GabrielHCaribe/drone/CAD/Propeller 10x45.STEP

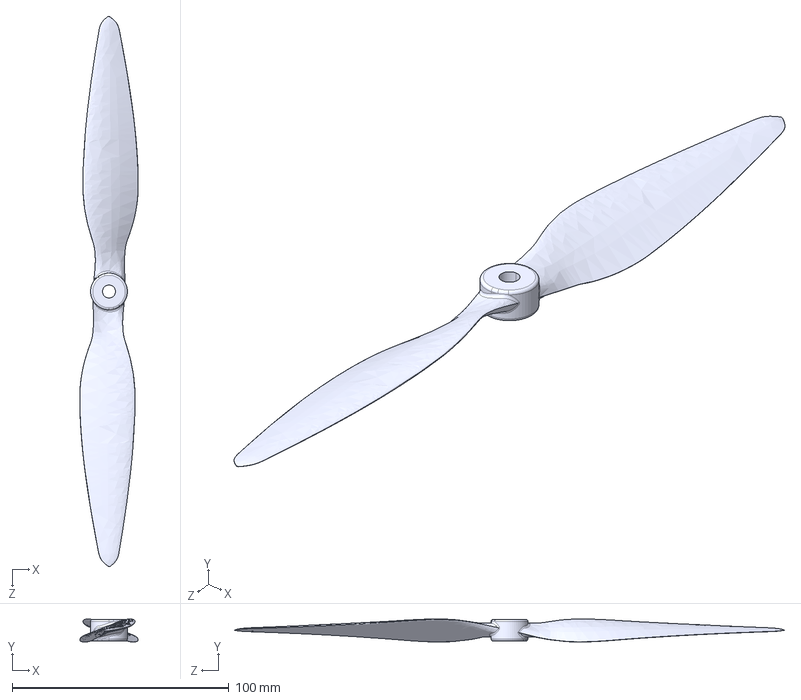
[picture p1: CAD file, 2026-10-03]
CAD/Propeller 10x45.STEP
27.0 x 10.6 x 254.0 mm
