GabrielHCaribe/drone/CAD/ESP32-WROOM-32.step

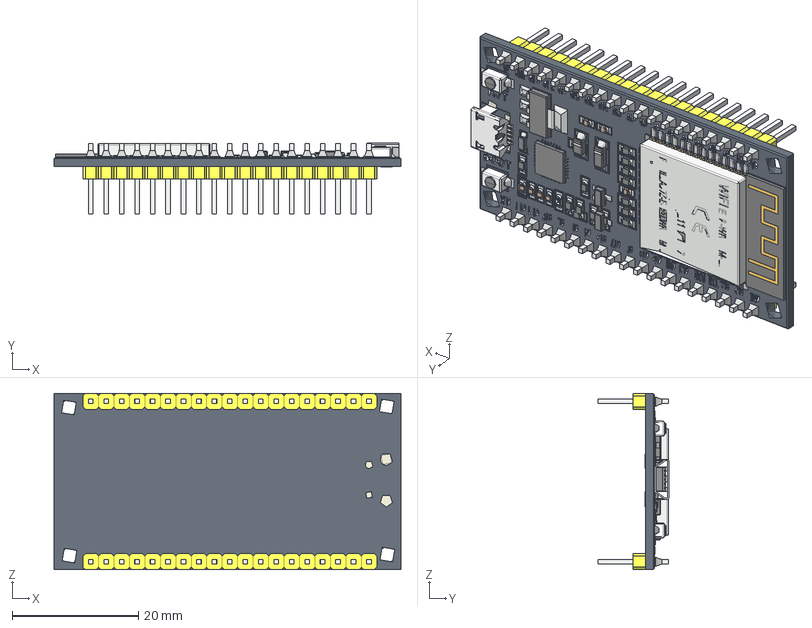
[picture p2: CAD file, 2026-10-03]
CAD/ESP32-WROOM-32.step
55.0 x 11.2 x 27.9 mm
pcb Geometry
TEXT
SW Geometry x 2
Botton x 2
sold x 2
cu x 2
Soket Geometry
Frame
cu2
pin
Transistor Geometry x 2
pin2 x 2
cu3 x 2
R Geometry x 16
pin3 x 16
cu4 x 16
C Geometry x 7
Pin-sold x 7
cu5 x 7
IC1 Geometry
sold2
CPU Geometry
Sold3
IC2 Geometry
pin4
weld
D Geometry
Pin-sold2
cu7
labl
LED Geometry
pin5
cu8
D1 Geometry
Pin-sold3
cu9
D2 Geometry
Pin-sold4
cu10
labl2
pin6 x 38
