GabrielHCaribe/drone/(commit log)

2026-10-02 Add ESP32 flight firmware, iPhone app, laptop ground station and CI
    - firmware/DroneFC: Arduino sketch for ESP32-WROOM-32 + MPU6500 (SPI).
    1 kHz control task pinned to core 1 (Mahony AHRS, angle->rate cascaded
    PID with setpoint feedforward, Quad-X mixer, 400 Hz ESC PWM), WiFi AP +
    binary UDP link on core 0. Arming checks, failsafe hover->land, follow
    timer, low-battery landing, crash detection, latched kill, motor test,
    ESC calibration, runtime-tunable params saved to NVS.
    - ios: SwiftUI app with Remote role (pink sticks, tuning, motor test) and
    Drone role (front camera, Vision person tracking, height Kalman filter,
    follow outer loops, JPEG video to laptop). Built by XcodeGen i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
    [DroneFC.ino, attitude.cpp, attitude.h, config.h, flight.cpp, flight.h, imu.cpp]
2026-10-02 Add docs, vision height readout, Swift fixes
    - docs: wiring, ESP32 upload, iOS build via GitHub Actions + TestFlight,
    laptop ground station, protocol, testing order, tuning guide; README.
    - iOS: rename LandReason.none to avoid Optional.none ambiguity, explicit
    SIMD3 literals, non-deprecated long-press API, show vision-measured
    camera height for the hand-held follow checks.
    Claude-Session: https://claude.ai/code/session_01PUpenwYbDxXJounR3QgQMB
2026-10-03 Add bench mode so the board can be tested with the app without an IMU
    With no IMU at boot the control loop skipped every cycle, so app commands
    were never processed. It now runs on a fake level reading; arming and gyro
    calibration stay refused.
    [DroneFC.ino, flight.cpp]
2026-10-03 Rename PinkDrone to DroneBoyfriendTracker
    Covers the app name, bundle ID (com.gabrielhcaribe.droneboyfriendtracker),
    drone WiFi SSID, ground station, firmware boot messages and docs.
2026-10-03 Build the iOS app with Xcode 26 and add CAD models
    App Store Connect rejects uploads built with an SDK older than iOS 26, so the
    workflow now runs on macos-26 and selects the newest release Xcode.
    [ESP32-WROOM-32.step, Propeller 10x45.STEP]
2026-10-04 Add a hidden basic 'first iteration' look to the iOS app
    Theme.basic swaps the pink theme for plain system colours, flat buttons,
    no glow or hearts. Toggle with 'Switch look' in the ... menu (disabled
    while armed) or a 2 s long-press on the role picker title.
